RuthBerkie/ESP32-S3-MINI/ESP32-S3-MINI.kicad/ESP32-S3-MINI.kicad.csv

Reference | Qty | Value | DNP | Exclude from BOM | Exclude from Board | Exclude from Simulation | Exclude from Position Files | Footprint | Datasheet
C1 | 1 | 10u |  |  |  |  | ${EXCLUDE_FROM_POS_FILES} | Capacitor_SMD:C_0603_1608Metric
C2 | 1 | 10u |  |  |  |  | ${EXCLUDE_FROM_POS_FILES} | Capacitor_SMD:C_0603_1608Metric
C3 | 1 | 100n |  |  |  |  | ${EXCLUDE_FROM_POS_FILES} | Capacitor_SMD:C_0402_1005Metric
C4 | 1 | 100n |  |  |  |  | ${EXCLUDE_FROM_POS_FILES} | Capacitor_SMD:C_0402_1005Metric
C5 | 1 | 1u |  |  |  |  | ${EXCLUDE_FROM_POS_FILES} | Capacitor_SMD:C_0603_1608Metric
C6 | 1 | 10u |  |  |  |  | ${EXCLUDE_FROM_POS_FILES} | Capacitor_SMD:C_0603_1608Metric
C7 | 1 | 100n |  |  |  |  | ${EXCLUDE_FROM_POS_FILES} | Capacitor_SMD:C_0402_1005Metric
C8 | 1 | 1u |  |  |  |  | ${EXCLUDE_FROM_POS_FILES} | Capacitor_SMD:C_0603_1608Metric
D1 | 1 | CLV1L-FKB |  |  |  |  | ${EXCLUDE_FROM_POS_FILES} | LED_SMD:LED_Cree-PLCC4_3.2x2.8mm_CCW | http://www.cree.com/led-components/media/documents/CLV1L-FKB-1238.pdf
D2 | 1 | Green |  |  |  |  | ${EXCLUDE_FROM_POS_FILES} | LED_SMD:LED_0603_1608Metric
D3 | 1 | 1N5817 |  |  |  |  | ${EXCLUDE_FROM_POS_FILES} | Diode_THT:D_DO-41_SOD81_P10.16mm_Horizontal | http://www.vishay.com/docs/88525/1n5817.pdf
D4 | 1 | ESD9B3.3ST5G |  |  |  |  | ${EXCLUDE_FROM_POS_FILES} | Diode_SMD:D_SOD-923 | https://www.onsemi.com/pub/Collateral/ESD9B-D.PDF
D5 | 1 | ESD9B3.3ST5G |  |  |  |  | ${EXCLUDE_FROM_POS_FILES} | Diode_SMD:D_SOD-923 | https://www.onsemi.com/pub/Collateral/ESD9B-D.PDF
D6 | 1 | ESD9B3.3ST5G |  |  |  |  | ${EXCLUDE_FROM_POS_FILES} | Diode_SMD:D_SOD-923 | https://www.onsemi.com/pub/Collateral/ESD9B-D.PDF
FB1 | 1 | FerriteBead_Small |  |  |  |  | ${EXCLUDE_FROM_POS_FILES} | LED_SMD:LED_0805_2012Metric_Pad1.15x1.40mm_HandSolder
J1 | 1 | USB_C_Receptacle_USB2.0_16P |  |  |  |  | ${EXCLUDE_FROM_POS_FILES} | Connector_USB:USB_C_Receptacle_HRO_TYPE-C-31-M-12 | https://www.usb.org/sites/default/files/documents/usb_type-c.zip
J2 | 1 | Conn_01x04 |  |  |  |  | ${EXCLUDE_FROM_POS_FILES} | Connector_JST:JST_SH_SM04B-SRSS-TB_1x04-1MP_P1.00mm_Horizontal
J3 | 1 | Conn_02x05_Odd_Even |  |  |  |  | ${EXCLUDE_FROM_POS_FILES} | Connector_PinHeader_2.54mm:PinHeader_2x05_P2.54mm_Vertical
J4 | 1 | Conn_02x03_Odd_Even |  |  |  |  | ${EXCLUDE_FROM_POS_FILES} | Connector_PinHeader_2.54mm:PinHeader_2x03_P2.54mm_Vertical
R1 | 1 | 4K7 |  |  |  |  | ${EXCLUDE_FROM_POS_FILES} | Resistor_SMD:R_0402_1005Metric
R2 | 1 | 4K7 |  |  |  |  | ${EXCLUDE_FROM_POS_FILES} | Resistor_SMD:R_0402_1005Metric
R3 | 1 | 1k |  |  |  |  | ${EXCLUDE_FROM_POS_FILES} | Resistor_SMD:R_0402_1005Metric
R4 | 1 | 1k |  |  |  |  | ${EXCLUDE_FROM_POS_FILES} | Resistor_SMD:R_0402_1005Metric
R5 | 1 | 1k |  |  |  |  | ${EXCLUDE_FROM_POS_FILES} | Resistor_SMD:R_0402_1005Metric
R6 | 1 | 1k |  |  |  |  | ${EXCLUDE_FROM_POS_FILES} | Resistor_SMD:R_0402_1005Metric
R7 | 1 | 5K1 |  |  |  |  | ${EXCLUDE_FROM_POS_FILES} | Resistor_SMD:R_0402_1005Metric
R8 | 1 | 5K1 |  |  |  |  | ${EXCLUDE_FROM_POS_FILES} | Resistor_SMD:R_0402_1005Metric
R9 | 1 | 10k |  |  |  |  | ${EXCLUDE_FROM_POS_FILES} | Resistor_SMD:R_0402_1005Metric
R10 | 1 | 10k |  |  |  |  | ${EXCLUDE_FROM_POS_FILES} | Resistor_SMD:R_0402_1005Metric
R11 | 1 | 10k |  |  |  |  | ${EXCLUDE_FROM_POS_FILES} | Resistor_SMD:R_0402_1005Metric
SW1 | 1 | SW_SPST |  |  |  |  | ${EXCLUDE_FROM_POS_FILES} | Button_Switch_THT:SW_Tactile_SPST_Angled_PTS645Vx31-2LFS
SW2 | 1 | SW_SPST |  |  |  |  | ${EXCLUDE_FROM_POS_FILES} | Button_Switch_SMD:SW_SPST_B3U-1000P
SW3 | 1 | SW_SPST |  |  |  |  | ${EXCLUDE_FROM_POS_FILES} | Button_Switch_SMD:SW_SPST_B3U-1000P
U1 | 1 | LM1117MP-3.3 |  |  |  |  | ${EXCLUDE_FROM_POS_FILES} | Package_TO_SOT_SMD:SOT-223-3_TabPin2 | http://www.ti.com/lit/ds/symlink/lm1117.pdf
U2 | 1 | HDC3022 |  |  |  |  | ${EXCLUDE_FROM_POS_FILES} | Package_SON:WSON-8-1EP_2x2mm_P0.5mm_EP0.9x1.6mm
U3 | 1 | USBLC6-2SC6 |  |  |  |  | ${EXCLUDE_FROM_POS_FILES} | Package_TO_SOT_SMD:SOT-23-6 | https://www.st.com/resource/en/datasheet/usblc6-2.pdf
U4 | 1 | ESP32-S3-MINI-1 |  |  |  |  | ${EXCLUDE_FROM_POS_FILES} | PCM_Espressif:ESP32-S3-MINI-1
