RuthBerkie/ESP32-S3-MINI/ESP32-S3-MINI.kicad/ESP32-S3-MINI.kicad.pdf

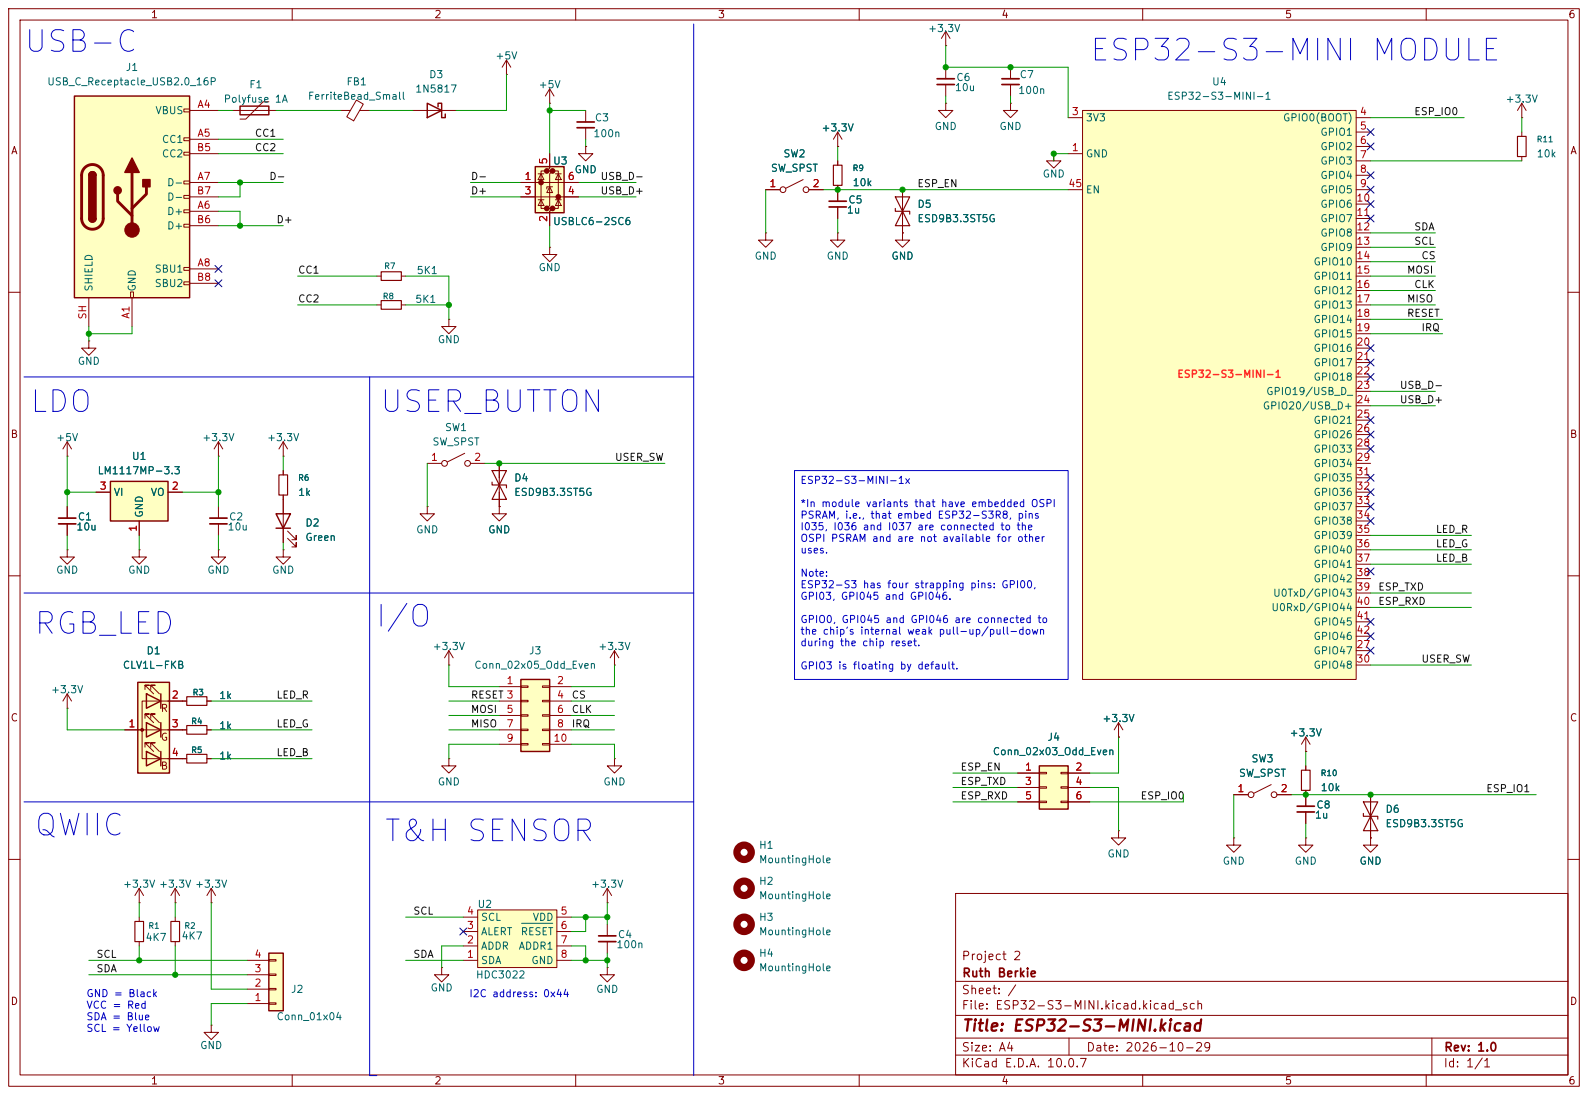
[picture p9: page 1]

*In module variants that have embedded OSPI PSRAM, i.e., that embed ESP32-S3R8, pins

I035, I036 and I037 are connected to the OSPI PSRAM and are not available for other uses. Note: ESP32-S3 has four strapping pins: GPI00,

GPI03, GPI045 and GPI046. GPIO0, GPI045 and GPI046 are connected to

the chip's internal weak pull-up/pull-down

during the chip reset. GPIO3 is floating by default. QWIIC
4 D1 CLV1L-FKB +3.3V

Size: A4 | Rev: 1.0
KiCad E.D.A. 10.0.7 | Id: 1/1
