RuthBerkie/ESP32-S3-MINI/ESP32-S3-MINI.kicad/ESP32-S3-MINI.kicad.kicad_pcb

## KiCad design ESP32-S3-MINI.kicad/ESP32-S3-MINI.kicad.kicad_pcb (2026-11-01)

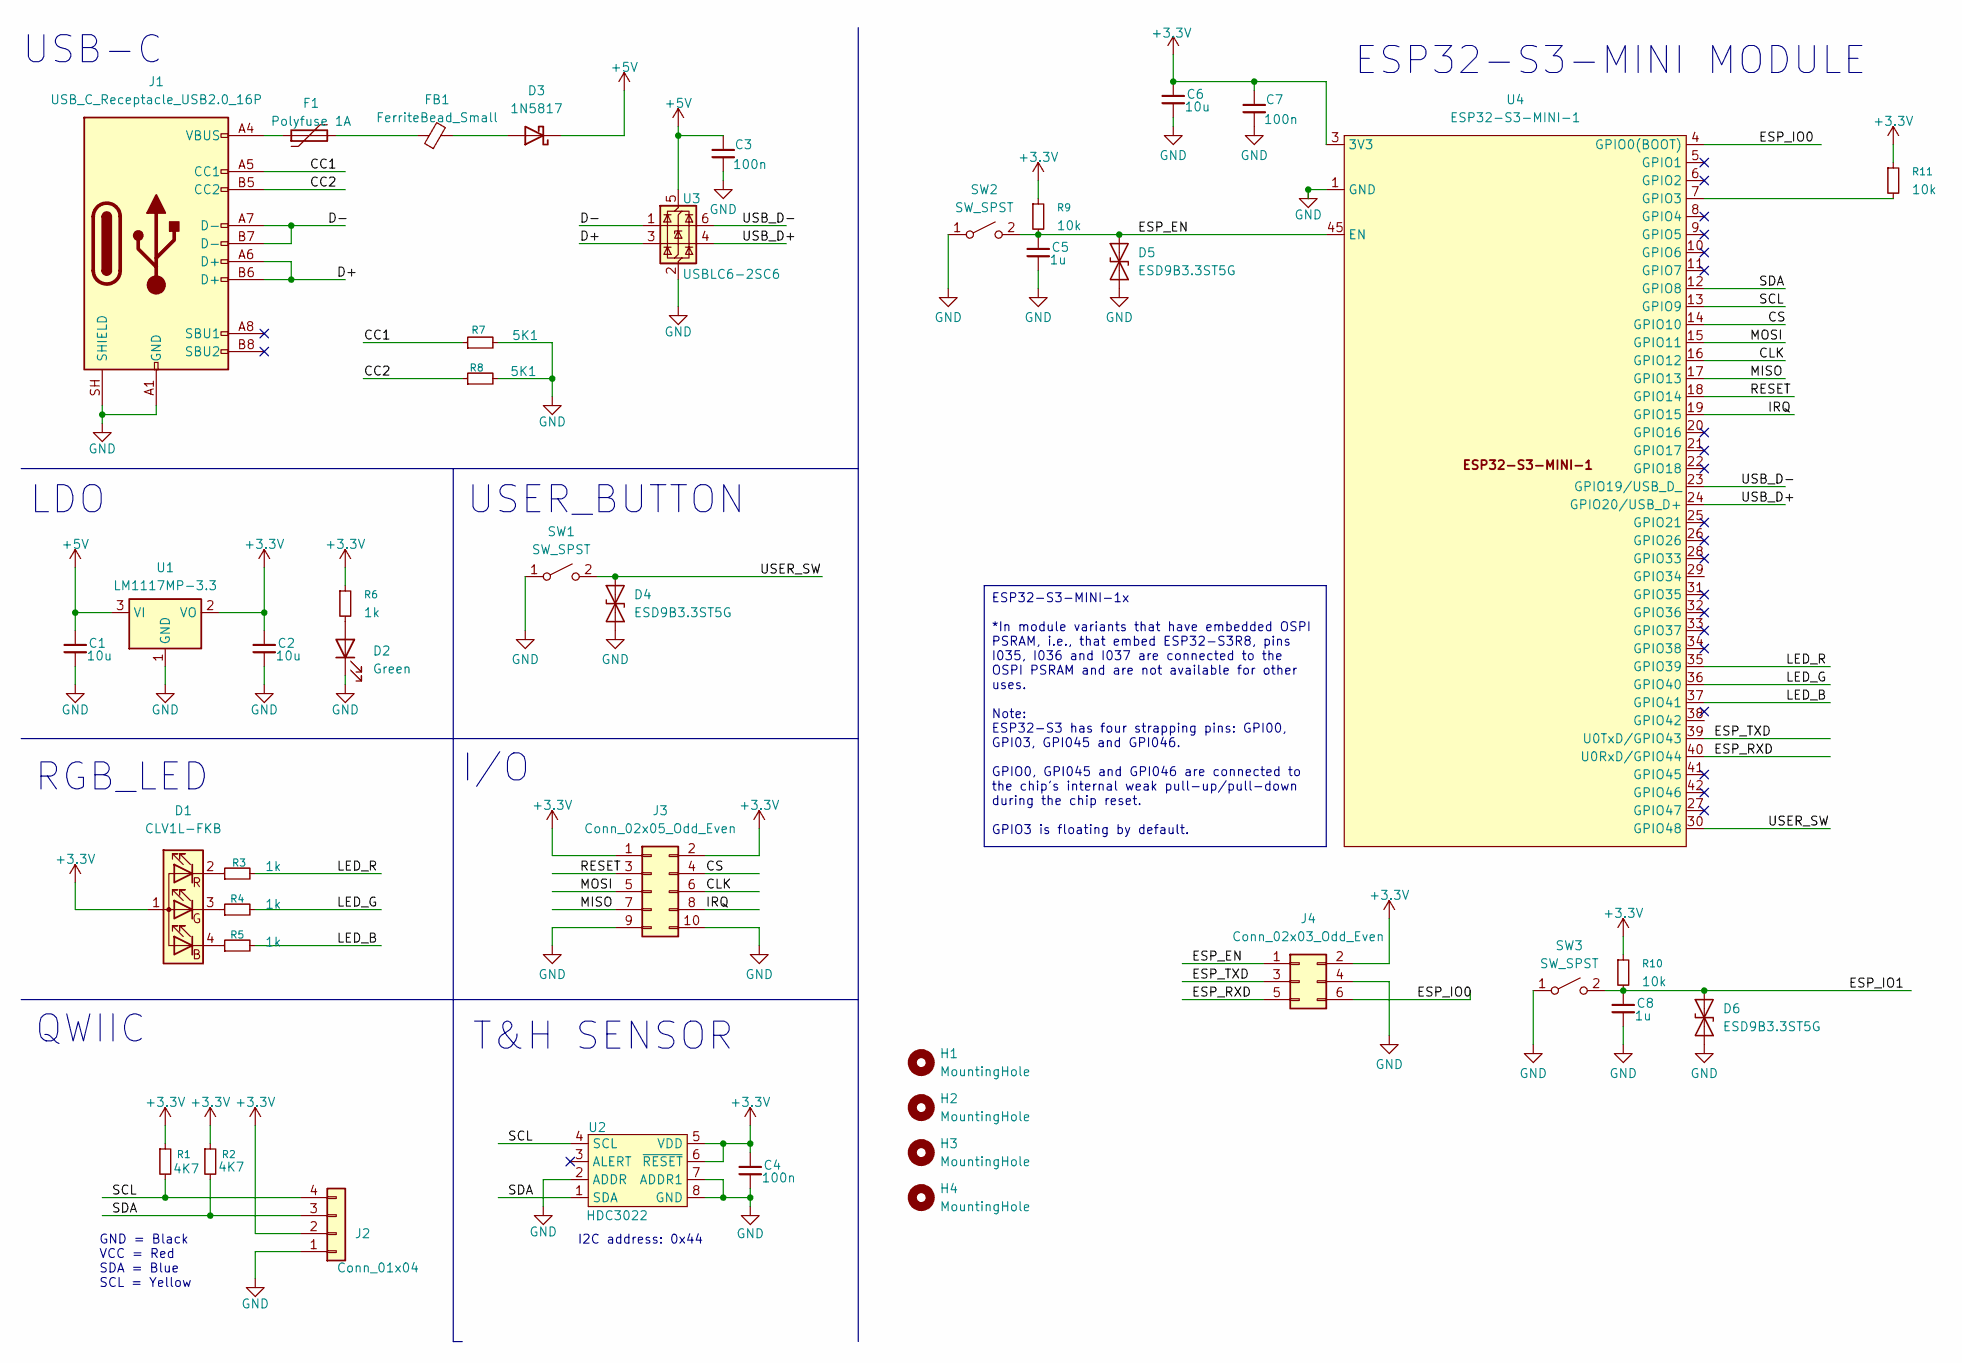
[picture p10: schematic ESP32-S3-MINI.kicad.kicad_sch, ESP32-S3-MINI]

Parts:
C1, C2, C6: 10u; C_0603_1608Metric
C3, C4, C7: 100n; C_0402_1005Metric
C5, C8: 1u; C_0603_1608Metric
D1: CLV1L-FKB; LED_Cree-PLCC4_3.2x2.8mm_CCW
D2: Green; LED_0603_1608Metric
D3: 1N5817; D_DO-41_SOD81_P10.16mm_Horizontal
D4, D5, D6: ESD9B3.3ST5G; D_SOD-923
F1: Polyfuse 1A; Fuse_1206_3216Metric
FB1: FerriteBead_Small; LED_0805_2012Metric_Pad1.15x1.40mm_HandSolder
H1, H2, H3, H4: MountingHole; MountingHole_3.2mm_M3_DIN965
J1: USB_C_Receptacle_USB2.0_16P; USB_C_Receptacle_HRO_TYPE-C-31-M-12
J2: Conn_01x04; JST_SH_SM04B-SRSS-TB_1x04-1MP_P1.00mm_Horizontal
J3: Conn_02x05_Odd_Even; PinHeader_2x05_P2.54mm_Vertical
J4: Conn_02x03_Odd_Even; PinHeader_2x03_P2.54mm_Vertical
R1, R2: 4K7; R_0402_1005Metric
R3, R4, R5, R6: 1k; R_0402_1005Metric
R7, R8: 5K1; R_0402_1005Metric
R9, R10, R11: 10k; R_0402_1005Metric
SW1: SW_SPST; SW_Tactile_SPST_Angled_PTS645Vx31-2LFS
SW2, SW3: SW_SPST; SW_SPST_B3U-1000P
U1: LM1117MP-3.3; SOT-223-3_TabPin2
U2: HDC3022; DEJ0008A-C01-IPC_A
U3: USBLC6-2SC6; SOT-23-6
U4: ESP32-S3-MINI-1

Connections:
+3.3V: C2.1, C4.1, C6.1, C7.1, D1.1 (A), J2.2, J3.1, J3.2, J4.2, R1.1, R2.1, R6.1, R9.1, R10.1, R11.1, U1.2 (VO), U2.5 (VDD), U2.6 (~RESET), U4.3 (3V3)
+5V: C1.1, C3.1, D3.1 (K), U1.3 (VI), U3.5 (VBUS)
/CC1: J1.A5 (CC1), R7.1
/CC2: J1.B5 (CC2), R8.1
/CLK: J3.6, U4.16 (GPIO12)
/CS: J3.4, U4.14 (GPIO10)
/D+: J1.A6 (D+), J1.B6 (D+), U3.3 (I/O2)
/D-: J1.A7 (D-), J1.B7 (D-), U3.1 (I/O1)
/ESP_EN: C5.1, D5.2 (A2), J4.1, R9.2, SW2.2 (B), U4.45 (EN); also elsewhere on the board
/ESP_IO0: J4.6, U4.4 (GPIO0(BOOT))
/ESP_IO1: C8.1, D6.2 (A2), R10.2, SW3.2 (B); also elsewhere on the board
/ESP_RXD: J4.5, U4.40 (U0RxD/GPIO44)
/ESP_TXD: J4.3, U4.39 (U0TxD/GPIO43)
/IRQ: J3.8, U4.19 (GPIO15)
/LED_B: R5.2, U4.37 (GPIO41)
/LED_G: R4.2, U4.36 (GPIO40)
/LED_R: R3.2, U4.35 (GPIO39)
/MISO: J3.7, U4.17 (GPIO13)
/MOSI: J3.5, U4.15 (GPIO11)
/RESET: J3.3, U4.18 (GPIO14)
/SCL: J2.4, R1.2, U2.4 (SCL), U4.13 (GPIO9)
/SDA: J2.3, R2.2, U2.1 (SDA), U4.12 (GPIO8)
/USB_D+: U3.4 (I/O2), U4.24 (GPIO20/USB_D+)
/USB_D-: U3.6 (I/O1), U4.23 (GPIO19/USB_D_)
/USER_SW: D4.2 (A2), SW1.2 (B), U4.30 (GPIO48)
GND: C1.2, C2.2, C3.2, C4.2, C5.2, C6.2, C7.2, C8.2, D2.1 (K), D4.1 (A1), D5.1 (A1), D6.1 (A1), J1.A1 (GND), J1.A12 (GND), J1.B1 (GND), J1.B12 (GND), J1.SH (SHIELD), J2.1, J3.9, J3.10, J4.4, R7.2, R8.2, SW1.1 (A), SW2.1 (A), SW3.1 (A), U1.1 (GND), U2.2 (ADDR), U2.7 (ADDR1), U2.8 (GND), U3.2 (GND), U4.1 (GND); also elsewhere on the board
unnamed: D1.4 (BK), R5.1
unnamed: D1.3 (GK), R4.1
unnamed: D1.2 (RK), R3.1
unnamed: D2.2 (A), R6.2
unnamed: D3.2 (A), FB1.2
unnamed: F1.1, J1.A4 (VBUS), J1.A9 (VBUS), J1.B4 (VBUS), J1.B9 (VBUS)
unnamed: F1.2, FB1.1
unnamed: R11.2, U4.7 (GPIO3)

Notes on the sheet:
RGB_LED
USB-C
ESP32-S3-MINI MODULE
QWIIC
USER_BUTTON
T&H SENSOR
LDO
I2C address: 0x44
I/O
GND = Black VCC = Red SDA = Blue SCL = Yellow
ESP32-S3-MINI-1x *In module variants that have embedded OSPI PSRAM, i.e., that embed ESP32-S3R8, pins I035, I036 and I037 are connected to the OSPI PSRAM and are not available for other uses. Note: ESP32-S3 has four strapping pins: GPI00, GPI03, GPI045 and GPI046. GPIO0, GPI045 and GPI046 are conne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

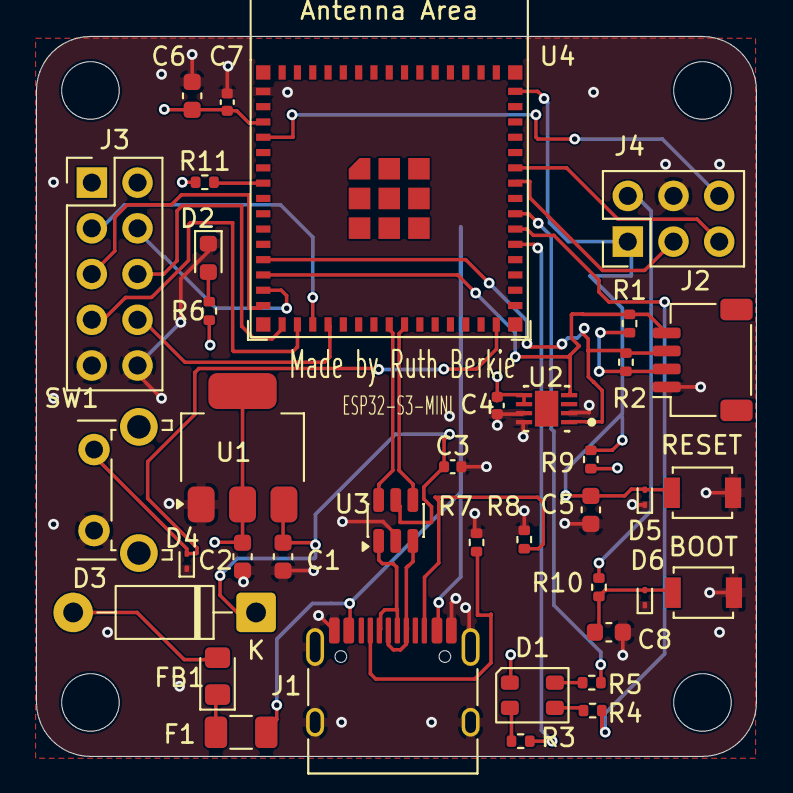
[picture p11: board ESP32-S3-MINI.kicad.kicad_pcb from above]

Board: 4 copper layers, 40.0 x 40.0 mm, 42 parts (0 on the bottom side), 34 nets.

Other parts of the board:
BOOT: SW_SPST; SW_SPST_B3U-1000P
RESET: SW_SPST; SW_SPST_B3U-1000P

Their connections:
/ESP_EN: RESET.2 (B); also elsewhere on the board
/ESP_IO1: BOOT.2 (B); also elsewhere on the board
GND: BOOT.1 (A), RESET.1 (A); also elsewhere on the board
