RuthBerkie/ESP32-S3-MINI/(commit log)

2026-11-03 Add detailed system overview for ESP32-S3-MINI
    Added a comprehensive overview of the ESP32-S3-MINI system, detailing the operational sequence from power entry to environmental data collection and user feedback.
2026-11-03 Add schematic image for ESP32-S3-MINI
    Added a schematic image to the README for visual reference.
2026-11-04 Enhance README with detailed PCB and connection info
    Expanded the technical lifecycle report for the board, detailing the PCB stackup and layer functions, as well as connections for power, sensors, and user interfaces.
2026-11-04 Fix image filename for schematic diagram
    Corrected the image file name for the schematic diagram in the README.
2026-11-04 Fix image reference for ESP32-S3-MINI schematic
    Corrected the image file name in the README.
